yymmaa0000/Trash_Delivery_Robot_Design_Project/Documentation/State Machine.jpg

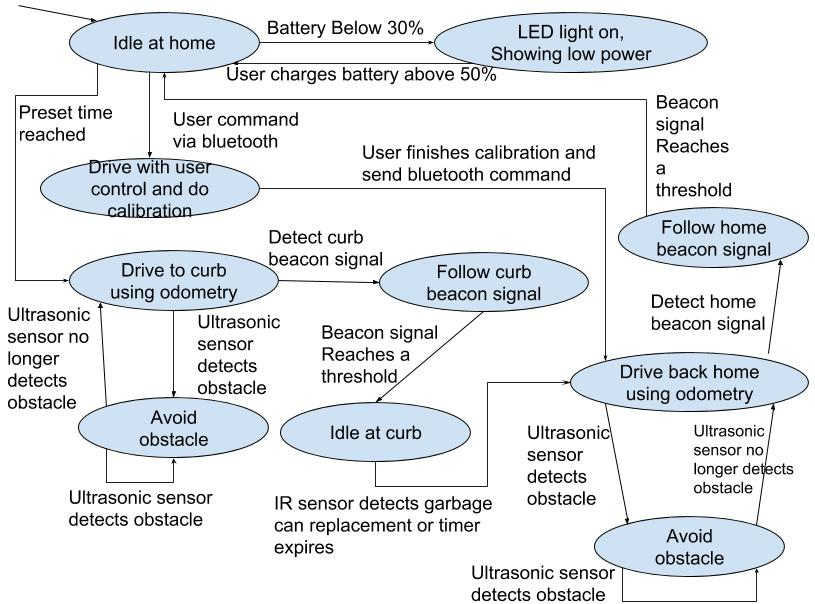
Documentation/State Machine.jpg
