yymmaa0000/Trash_Delivery_Robot_Design_Project/Navigation_v7.ino

#include <QuadratureEncoder.h>
#include <Servo.h>

//---------------- Compass and IR sensor--------------------------------
#define SDA_PORT PORTB
#define SDA_PIN 5 // = 11
#define SCL_PORT PORTB
#define SCL_PIN 6 // = 12
#include <SoftI2CMaster.h>
#include <Adafruit_Sensor.h>
#include "Adafruit_TSL2591.h"
const int compass_i2c_addr = 0x28;
const int OPR_register_addr = 0x3D;
const int compass_operation_mode = 0x08;    //Compass mode(Gyro+Mag)
const int compass_dataout_register = 0x1A;  //Euler Angle
Adafruit_TSL2591 tsl = Adafruit_TSL2591(2591);

struct IRPACKAGE{
  uint16_t ir;
  double ratio;
};
IRPACKAGE irpackage;
double heading = 0.0;

//---------------- Servo --------------------------------
//Initialize Servo Angle
double servoangle = 90;
const int servopin = 10;
Servo IRservo;
float angleturnto = 0.0;

//---------------- Ultrasonic --------------------------------
const int EchoPin =26; 
const int TrigPin =27; 

const int L_EchoPin =7; 
const int L_TrigPin =6; 

const int R_EchoPin =9; 
const int R_TrigPin =8; 

float ultrasonic_distance; 
float L_distance; 
float R_distance; 

//---------------- Utility --------------------------------
const int red_LED = 22;
const int green_LED = 23;
const int yellow_LED = 52;
const int white_LED = 53;
const int button_pin = 24;
unsigned long lastMilli = 0;

//---------------- motor --------------------------------
Encoders leftEncoder(A8,A9);  // left front motor
Encoders rightEncoder(A15,A14); // right front motor
Encoders leftEncoder2(A13,A12);  // left back motor
Encoders rightEncoder2(A11,A10); // right back motor

const int motorl2_pwm = 4;// right front
const int motorl2_dir = 37;
const int motorl1_pwm = 2; // right rear
const int motorl1_dir = 33;
const int motorl2_enable = 38;
const int motorl1_enable = 34;
const int motorr2_pwm = 3;// left front
const int motorr2_dir = 35;
const int motorr1_pwm = 5; // left rear
const int motorr1_dir = 39;
const int motorr2_enable = 36;
const int motorr1_enable = 40;

//---------------- bluetooth --------------------------------
const int relay = 41; // switch
const int b_state = 42; // bluetooth state
const int b_enable = 43; // bluetooth enable
byte BT_COM;
const int ms_time = 800;
int RX = 0;
int TX = 1;
#define Triq1  6
#define Echo1  7
#define Triq2  8
#define Echo2  9
double distance1;
double distance2;
//#define IR_pin 

//------------------ Motion and Odometry ------------------------------
const int motor_speed = 64;
// target direction, result of calibration
int target_number = 0;
long target_dis[64];
float target_dir[64];
const int max_power = 192; // maximun power of the motor
// do not increase it because it may burn the motor!!!!!

void setup() {
  pinMode(red_LED,OUTPUT);
  pinMode(green_LED,OUTPUT);
  pinMode(white_LED,OUTPUT);
  pinMode(yellow_LED,OUTPUT);
  pinMode(motorr1_pwm,OUTPUT);
  pinMode(motorr1_dir,OUTPUT);
  pinMode(motorr2_pwm,OUTPUT);
  pinMode(motorr2_dir,OUTPUT);
  pinMode(motorr1_enable,OUTPUT);
  pinMode(motorr2_enable,OUTPUT);
  pinMode(motorl1_pwm,OUTPUT);
  pinMode(motorl1_dir,OUTPUT);
  pinMode(motorl2_pwm,OUTPUT);
  pinMode(motorl2_dir,OUTPUT);
  pinMode(motorl1_enable,OUTPUT);
  pinMode(motorl2_enable,OUTPUT);

  pinMode(Triq1,OUTPUT);
  pinMode(Echo1,INPUT);
  pinMode(Triq2,OUTPUT);
  pinMode(Echo2,INPUT);

  pinMode(TX,OUTPUT);
  pinMode(RX,INPUT);
  pinMode(b_state,INPUT);
  pinMode(b_enable, OUTPUT);

  pinMode(TrigPin, OUTPUT); //placement
  pinMode(EchoPin, INPUT); 

  pinMode(L_TrigPin, OUTPUT); //placement
  pinMode(L_EchoPin, INPUT); 
  
  pinMode(R_TrigPin, OUTPUT); //placement
  pinMode(R_EchoPin, INPUT); 
  
  //Serial.begin(57600);
  Serial.begin(9600);

//------------------ compass and IR sesnor ------------------------------
  pinMode(20, INPUT);
  pinMode(21, INPUT);
  digitalWrite(20, LOW); //disable internal pullup resistor
  digitalWrite(21, LOW); //disable internal pullup resistor
  i2c_initiation();
  i2c_set_mode();
  IR_init();

//------------------ servo ------------------------------
  IRservo.attach(servopin);
  //servo_angle(servoangle);        //Initialize servo to 90

//------------------ calibration ------------------------------

  digitalWrite(white_LED,HIGH);
  calibration();
  digitalWrite(white_LED,LOW);
}

void loop() {
  wait_for_buttom();
  digitalWrite(green_LED,LOW);
  go_home();
  IR_navigation();
  digitalWrite(green_LED,HIGH);
  wait_for_buttom();
  digitalWrite(green_LED,LOW);
  go_to_curb();
  IR_navigation();
  digitalWrite(green_LED,HIGH);
}
